open-ultrasound/open-imager/Hardware/1010260-900-0012_PCB/ch1477998-1 - Stackup Report.pdf

# STACKUP & IMPEDANCE REPORT

Page 1 of 1

### Planner: RICKG Confidential / Proprietary Information

### Customer Required Finished Thickness: 86.00 (+8.60 / -8.60) mils

### Measured: Over mask on plated copper

### Job Name: Customer:

ch1477998-1

### Part Name:

### Creare Stack-up

Revision: | Estimated Thickness after Lamination: 84.18 mils

Outer layers to finish at 1 oz.

### Preliminary stack up : Data not provided

### Stackup Notes:

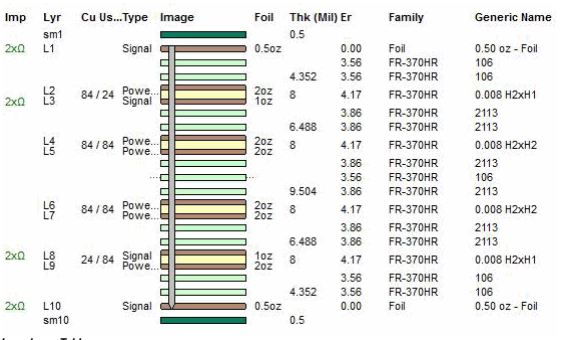
[picture p9: figure]

Index | Layer | Required Impedance [ohms] | Tol [ohms] +/- | Type | Ref 1 | Ref 2 | Orig LW [mil] | Orig Spacing [mil] | Orig CP Spacing [mil] | Finished LW [mil] | Finished Spacing [mil] | Fin. CP Spacing [mil] | Impedance Simulation [ohms] | Impedance before Mask [ohms] | IMG
a | 1 | 100 | 10% | Diff Coated | | 2 | 5.50 | 6.90 | | 5.50 | 6.90 | | 99.8
b | 10 | 100 | 10% | Diff Coated | | 9 | 5.50 | 6.90 | | 5.50 | 6.90 | | 99.8
c | 3 | 100 | 10% | Diff Stripline | 4 | 2 | 4.70 | 8.00 | | 4.70 | 8.00 | | 99.3
d | 8 | 100 | 10% | Diff Stripline | 7 | 9 | 4.70 | 8.00 | | 4.70 | 8.00 | | 99.3
e | 1 | 50 | 10% | SE Coated | | 2 | 7.70 | | | 7.70 | | | 49.9
f | 3 | 50 | 10% | SE Stripline | 4 | 2 | 6.00 | | | 6.00 | | | 49.6
g | 8 | 50 | 10% | SE Stripline | 7 | 9 | 6.00 | | | 6.00 | | | 49.6
h | 10 | 50 | 10% | SE Coated | | 9 | 7.70 | | | 7.70 | | | 49.9

Impedance Table

Report Version 1.60 | Report Print Date/Time: 1/28/2020 | 11:46:08AM | Page 1 of 1
