open-ultrasound/open-imager/OpenImageEval/OpenImageEval.sdk/FSBL/bootimage/ProgramFlashMemory.png

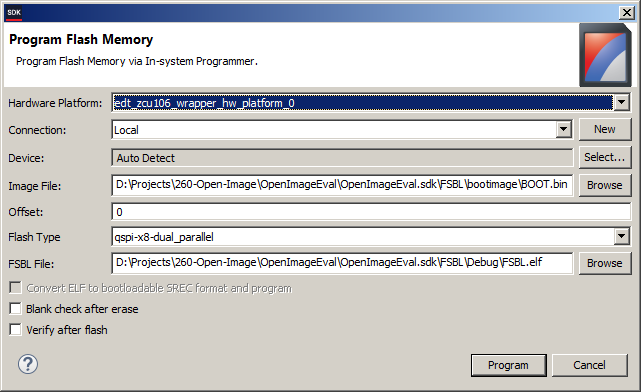
OpenImageEval/OpenImageEval.sdk/FSBL/bootimage/ProgramFlashMemory.png
