open-ultrasound/open-imager/Documents/OpenImageDesign.xlsx

Sheet: FMC Pinout, J5 Mate
J5 Pin | Eval Schematic Net Name | I/O Standard | U1 Pin | U1 Bank | Interposer Net Name | Destination I/C | Pin
C10 | FMC_HPC0_LA06_P | LVCMOS18 | H19 |  | PLSR3_SEL2 | HV7321 #3 | 16
C11 | FMC_HPC0_LA06_N | LVCMOS18 | G19 |  | PLSR3_CLK |  | 8
C14 | FMC_HPC0_LA10_P | LVCMOS18 | L15 |  | PLSR2_NEG3 | HV7321 #2 | 17
C15 | FMC_HPC0_LA10_N | LVCMOS18 | K15 |  | PLSR2_NEG2 |  | 13
C18 | FMC_HPC0_LA14_P | LVCMOS18 | C13 |  | AFE_TRIGp | Both AD9670 | J2
C19 | FMC_HPC0_LA14_N | LVCMOS18 | C12 |  | AFE_TRIGn | Both AD9670 | H2
C22 | FMC_HPC0_LA18_CC_P | LVCMOS18 | D11 |  | PLSR1_NEG3 | HV7321 #1 | 17
C23 | FMC_HPC0_LA18_CC_N | LVCMOS18 | D10 |  | PLSR1_NEG2 |  | 13
C26 | FMC_HPC0_LA27_P | LVCMOS18 | A8 |  | PLSR1_NEG1 |  | 3
C27 | FMC_HPC0_LA27_N | LVCMOS18 | A7 |  | PLSR1_SEL0 |  | 62
C34 | GND |  |  |  | GND
C35 | VCC12_SW |  |  |  | V1.2
C37 | VCC12_SW |  |  |  | V1.2
C39 | UTIL_3V3 |  |  |  | V3.3
D8 | FMC_HPC0_LA01_CC_P | LVCMOS18 | H18 |  | PLSR2_NEG1 | HV7321 #2 | etc.
D9 | FMC_HPC0_LA01_CC_N | LVCMOS18 | H17 |  | PLSR2_SEL0
D11 | FMC_HPC0_LA05_P | LVCMOS18 | K17 |  | PLSR2_NEG0
D12 | FMC_HPC0_LA05_N | LVCMOS18 | J17 |  | PLSR2_POS3
D14 | FMC_HPC0_LA09_P | LVCMOS18 | H16 |  | PLSR2_SEL1
D15 | FMC_HPC0_LA09_N | LVCMOS18 | G16 |  | PLSR2_POS2
D17 | FMC_HPC0_LA13_P | LVCMOS18 | G15 |  | PLSR2_POS1
D18 | FMC_HPC0_LA13_N | LVCMOS18 | F15 |  | PLSR2_POS0
D20 | FMC_HPC0_LA17_CC_P | LVCMOS18 | F11 |  | AFE1_FCOp | AD9670 #1 | L7
D21 | FMC_HPC0_LA17_CC_N | LVCMOS18 | E10 |  | AFE1_FCOn |  | M7
D23 | FMC_HPC0_LA23_P | LVCMOS18 | B11 |  | PLSR1_SEL3 | HV7321 #1
D24 | FMC_HPC0_LA23_N | LVCMOS18 | A11 |  | PLSR1_SEL2
D26 | FMC_HPC0_LA26_P | LVCMOS18 | B9 |  | PLSR1_CLK
D27 | FMC_HPC0_LA26_N | LVCMOS18 | B8 |  | PLSR3_SEL3 | HV7321 #3
D32 | UTIL_3V3 |  |  |  | V3.3
D35 | GND |  |  |  | GND
D36 | UTIL_3V3 |  |  |  | V3.3
D38 | UTIL_3V3 |  |  |  | V3.3
D40 | UTIL_3V3 |  |  |  | V3.3
E39 | VADJ_FMC_BUS |  |  |  | V1.8
F40 | VADJ_FMC_BUS |  |  |  | V1.8
G2 | FMC_HPC0_CLK1_M2C_P | LVDS | G10 |  | AFE1_DCOp | AD9670 #1 | L6
G3 | FMC_HPC0_CLK1_M2C_N | LVDS | F10 |  | AFE1_DCOn |  | M6
G6 | FMC_HPC0_LA00_CC_P | LVDS | F17 |  | AFE0_FCOp | AD9670 #0 | L7
G7 | FMC_HPC0_LA00_CC_N | LVDS | F16 |  | AFE0_FCOn |  | M7
G9 | FMC_HPC0_LA03_P | LVCMOS18 | K19 |  | AFE0_DATA2p |  | L9
G10 | FMC_HPC0_LA03_N | LVCMOS18 | K18 |  | AFE0_DATA2n |  | M9
G12 | FMC_HPC0_LA08_P | LVCMOS18 | E18 |  | AFE0_DATA1p |  | L10
G13 | FMC_HPC0_LA08_N | LVCMOS18 | E17 |  | AFE0_DATA1n |  | M10
G15 | FMC_HPC0_LA12_P | LVCMOS18 | G18 |  | AFE0_DATA0p |  | L11
G16 | FMC_HPC0_LA12_N | LVCMOS18 | F18 |  | AFE0_DATA0n |  | M11
G18 | FMC_HPC0_LA16_P | LVCMOS18 | D17 |  | PLSR2_SEL3 | HV7321 #2
G19 | FMC_HPC0_LA16_N | LVCMOS18 | C17 |  | PLSR2_SEL2
G21 | FMC_HPC0_LA20_P | LVCMOS18 | F12 |  | PLSR2_CLK
G22 | FMC_HPC0_LA20_N | LVCMOS18 | E12 |  | Testpoint pad.
G24 | FMC_HPC0_LA22_P | LVCMOS18 | H13 |  | AFE1_DATA7p | AD9670 #1 | L2
G25 | FMC_HPC0_LA22_N | LVCMOS18 | H12 |  | AFE1_DATA7n |  | M2
G27 | FMC_HPC0_LA25_P | LVCMOS18 | C7 |  | AFE1_DATA6p |  | L3
G28 | FMC_HPC0_LA25_N | LVCMOS18 | C6 |  | AFE1_DATA6n |  | M3
G30 | FMC_HPC0_LA29_P | LVCMOS18 | K10 |  | AFE1_DATA5p |  | L4
G31 | FMC_HPC0_LA29_N | LVCMOS18 | J10 |  | AFE1_DATA5n |  | M4
G33 | FMC_HPC0_LA31_P | LVCMOS18 | F7 |  | AFE1_DATA4p |  | L5
G34 | FMC_HPC0_LA31_N | LVCMOS18 | E7 |  | AFE1_DATA4n |  | M5
G36 | FMC_HPC0_LA33_P | LVCMOS18 | C9 |  | AFE1_DATA3p |  | L8
G37 | FMC_HPC0_LA33_N | LVCMOS18 | C8 |  | AFE1_DATA3n |  | M8
G39 | VADJ_FMC_BUS |  |  |  | V1.8
H4 | FMC_HPC0_CLK0_M2C_P | LVDS | E15 |  | AFE0_DCOp | AD9670 #0 | L6
H5 | FMC_HPC0_CLK0_M2C_N | LVDS | E14 |  | AFE0_DCOn |  | M6
H7 | FMC_HPC0_LA02_P | LVCMOS18 | L20 |  | AFE0_DATA7p |  | L2
H8 | FMC_HPC0_LA02_N | LVCMOS18 | K20 |  | AFE0_DATA7n |  | M2
H10 | FMC_HPC0_LA04_P | LVCMOS18 | L17 |  | AFE0_DATA6p |  | L3
H11 | FMC_HPC0_LA04_N | LVCMOS18 | L16 |  | AFE0_DATA6n |  | M3
H13 | FMC_HPC0_LA07_P | LVCMOS18 | J16 |  | AFE0_DATA5p |  | L4
H14 | FMC_HPC0_LA07_N | LVCMOS18 | J15 |  | AFE0_DATA5n |  | M4
H16 | FMC_HPC0_LA11_P | LVCMOS18 | A13 |  | AFE0_DATA4p |  | L5
H17 | FMC_HPC0_LA11_N | LVCMOS18 | A12 |  | AFE0_DATA4n |  | M5
H19 | FMC_HPC0_LA15_P | LVCMOS18 | D16 |  | AFE0_DATA3p |  | L8
H20 | FMC_HPC0_LA15_N | LVCMOS18 | C16 |  | AFE0_DATA3n |  | M8
H22 | FMC_HPC0_LA19_P | LVCMOS18 | D12 |  | AFE1_DATA2p | AD9670 #1 | L9
H23 | FMC_HPC0_LA19_N | LVCMOS18 | C11 |  | AFE1_DATA2n |  | M9
H25 | FMC_HPC0_LA21_P | LVCMOS18 | B10 |  | AFE1_DATA1p |  | L10
H26 | FMC_HPC0_LA21_N | LVCMOS18 | A10 |  | AFE1_DATA1n |  | M10
H28 | FMC_HPC0_LA24_P | LVCMOS18 | B6 |  | AFE1_DATA0p |  | L11
H29 | FMC_HPC0_LA24_N | LVCMOS18 | A6 |  | AFE1_DATA0n |  | M11
H31 | FMC_HPC0_LA28_P | LVCMOS18 | M13 |  | PLSR1_NEG0 | HV7321 #1
H32 | FMC_HPC0_LA28_N | LVCMOS18 | L13 |  | PLSR1_POS3
H34 | FMC_HPC0_LA30_P | LVCMOS18 | E9 |  | PLSR1_SEL1
H35 | FMC_HPC0_LA30_N | LVCMOS18 | D9 |  | PLSR1_POS2
H37 | FMC_HPC0_LA32_P | LVCMOS18 | F8 |  | PLSR1_POS1
H38 | FMC_HPC0_LA32_N | LVCMOS18 | E8 |  | PLSR1_POS0
H40 | VADJ_FMC_BUS |  |  |  | V1.8

Sheet: FMC Pinout, J4 Mate
J4 Pin | Eval Schematic Net Name | I/O Standard | U1 Pin | U1 Bank | Interposer Net Name | Destination I/C | Pin
C10 | FMC_HPC1_LA06_P | LVDS | H21 |  | DAC_D4 | Both AD5424 | 7
C11 | FMC_HPC1_LA06_N | LVDS | H22 |  | DAC_D3 |  | 8
C14 | FMC_HPC1_LA10_P | LVDS | F22 |  | DAC_D5 |  | 6
C15 | FMC_HPC1_LA10_N | LVDS | E22 |  | DAC_D6 |  | 5
C18 | FMC_HPC1_LA14_P | LVDS | D20 |  | DAC1_CSn | AD5424 #1 | 12
C19 | FMC_HPC1_LA14_N | LVDS | D21 |  | DAC_D0 | Both AD5424 | 11
C34 | GND |  |  |  | GND
C35 | VCC12_SW |  |  |  | V1.2
C37 | VCC12_SW |  |  |  | V1.2
C39 | UTIL_3V3 |  |  |  | V3.3
D8 | FMC_HPC1_LA01_CC_P | LVDS | E24 |  | PLSR3_NEG3 | HV7321 #3
D9 | FMC_HPC1_LA01_CC_N | LVDS | D24 |  | PLSR0_CLK | HV7321 #0
D11 | FMC_HPC1_LA05_P | LVDS | G25 |  | PLSR0_SEL0
D12 | FMC_HPC1_LA05_N | LVDS | G26 |  | PLSR0_SEL1
D14 | FMC_HPC1_LA09_P | LVDS | G20 |  | DAC_D7 | Both AD5424 | 4
D15 | FMC_HPC1_LA09_N | LVDS | F20 |  | DAC0_CSn | AD5424 #0 | 11
D17 | FMC_HPC1_LA13_P | LVDS | C21 |  | PLSR3_NEG2
D18 | FMC_HPC1_LA13_N | LVDS | C22 |  | PLSR3_POS0
D32 | UTIL_3V3 |  |  |  | V3.3
D35 | GND |  |  |  | GND
D36 | UTIL_3V3 |  |  |  | V3.3
D38 | UTIL_3V3 |  |  |  | V3.3
D40 | UTIL_3V3 |  |  |  | V3.3
E39 | VADJ_FMC_BUS |  |  |  | V1.8
F40 | VADJ_FMC_BUS |  |  |  | V1.8
G6 | FMC_HPC1_LA00_CC_P | LVDS | B18 |  | PLSR0_NEG0 | HV7321 #0
G7 | FMC_HPC1_LA00_CC_N | LVDS | B19 |  | PLSR0_NEG1
G9 | FMC_HPC1_LA03_P | LVDS | J21 |  | PLSR3_NEG1 | HV7321 #3
G10 | FMC_HPC1_LA03_N | LVDS | J22 |  | bring to testpoint pad
G12 | FMC_HPC1_LA08_P | LVDS | J25 |  | AFE_CLKp | Both AD9670 | J1
G13 | FMC_HPC1_LA08_N | LVDS | H26 |  | AFE_CLKn |  | H1
G15 | FMC_HPC1_LA12_P | LVDS | E19 |  | PLSR3_SEL0 | HV7321 #3
G16 | FMC_HPC1_LA12_N | LVDS | D19 |  | PLSR3_NEG0
G18 | FMC_HPC1_LA16_P | LVDS | C18 |  | PLSR0_POS0 | HV7321 #0
G19 | FMC_HPC1_LA16_N | LVDS | C19 |  | PLSR0_POS1
G39 | VADJ_FMC_BUS |  |  |  | V1.8
H4 | FMC_HPC1_CLK0_M2C_P | LVDS | F23 |  | DAC_D1 | Both AD5424 | 10
H5 | FMC_HPC1_CLK0_M2C_N | LVDS | E23 |  | DAC_D2 |  | 9
H7 | FMC_HPC1_LA02_P | LVDS | K22 |  | PLSR3_POS3 | HV7321 #3
H8 | FMC_HPC1_LA02_N | LVDS | K23 |  | PLSR3_SEL1
H10 | FMC_HPC1_LA04_P | LVDS | J24 |  | PLSR3_POS2
H11 | FMC_HPC1_LA04_N | LVDS | H24 |  | PLSR3_POS1
H13 | FMC_HPC1_LA07_P | LVDS | D22 |  | PLSR0_SEL0 | HV7321 #0
H14 | FMC_HPC1_LA07_N | LVDS | C23 |  | PLSR0_SEL3
H16 | FMC_HPC1_LA11_P | LVDS | A20 |  | PLSR0_NEG2
H17 | FMC_HPC1_LA11_N | LVDS | A21 |  | PLSR0_NEG3
H19 | FMC_HPC1_LA15_P | LVDS | A18 |  | PLSR0_POS2
H20 | FMC_HPC1_LA15_N | LVDS | A19 |  | PLSR0_POS3
H40 | VADJ_FMC_BUS |  |  |  | V1.8

Sheet: Ribbon Pinout, J3 Mate
J3 Pin | Eval Schematic Net Name | I/O Standard | U1 Pin | U1 Bank | Interposer Net Name | Destination I/C | Pin
6 | L6N_AD6N_64_N | LVCMOS18 | K13 | 68 | PLSR_REN | All HV7321 | 11
8 | L6P_AD6P_64_P | LVCMOS18 | L14 | 68 | PLSR_OEN |  | 6
10 | L5N_AD14N_64_N | LVCMOS18 | J14 | 68 | PLSR0_OTPn | HV7321 #0 | 20
12 | L5P_AD14P_64_P | LVCMOS18 | K14 | 68 | PLSR1_OTPn | #1 | 20
14 | L4N_AD7N_64_N | LVCMOS18 | J11 | 68 | PLSR2_OTPn | #2 | 20
16 | L4P_AD7P_64_P | LVCMOS18 | K12 | 68 | PLSR3_OTPn | #3 | 20
18 | L3N_AD15N_64_N | LVCMOS18 | L11 | 68 | AFE_SDIO | Both AD9670 | J12
20 | L3P_AD15P_64_P | LVCMOS18 | L12 | 68 | AFE_SCK |  | K12
22 | L14N_HDGC_65_N | LVCMOS18 | G24 | 28 | AFE0_CSn | AD9670 #0 | H12
24 | L14P_HDGC_65_P | LVCMOS18 | G23 | 28 | AFE1_CSn | AD9670 #1 | H12
