open-ultrasound/open-imager/Hardware/1010260-900-0012_PCB/ASB.pdf

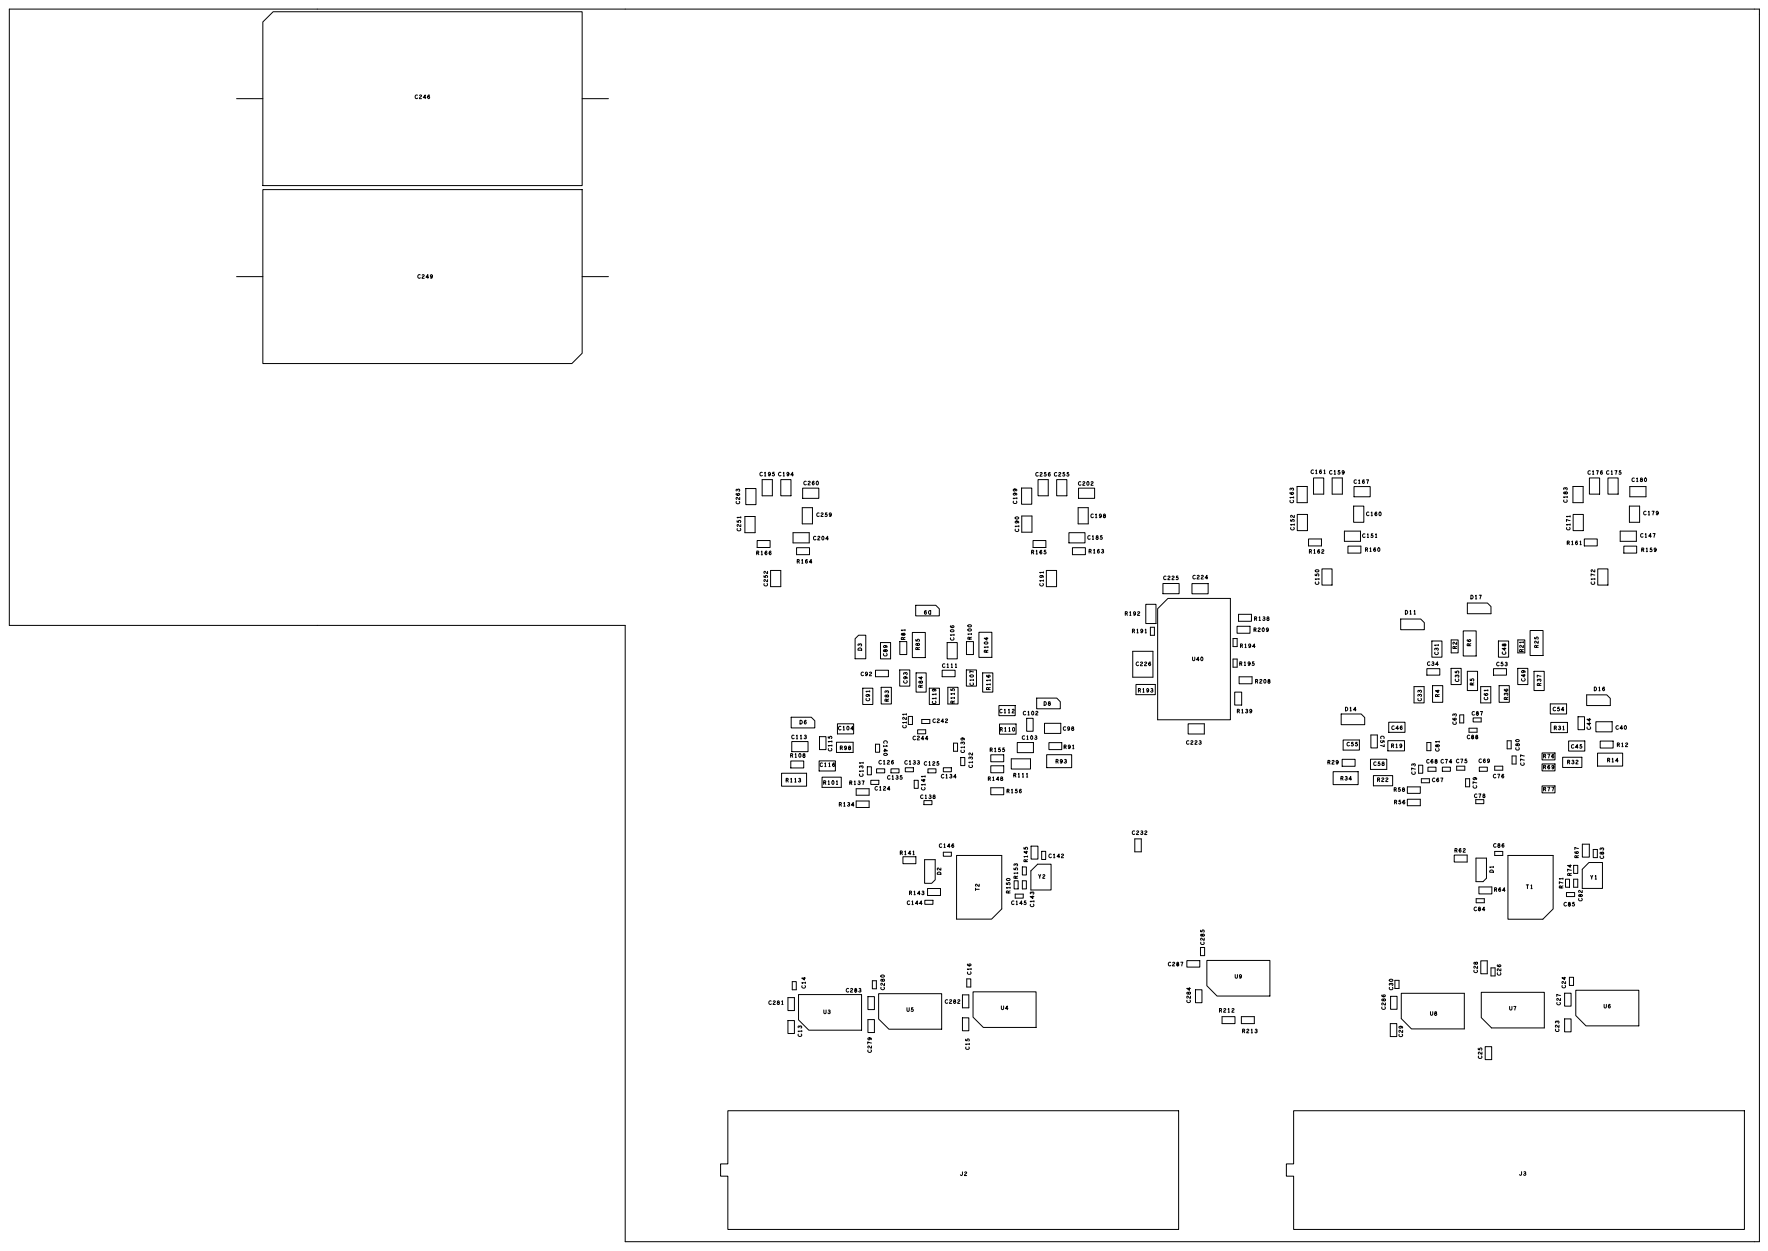
[picture p11: page 1]
