open-ultrasound/open-imager/Hardware/1010260-900-0012_PCB/AST.pdf

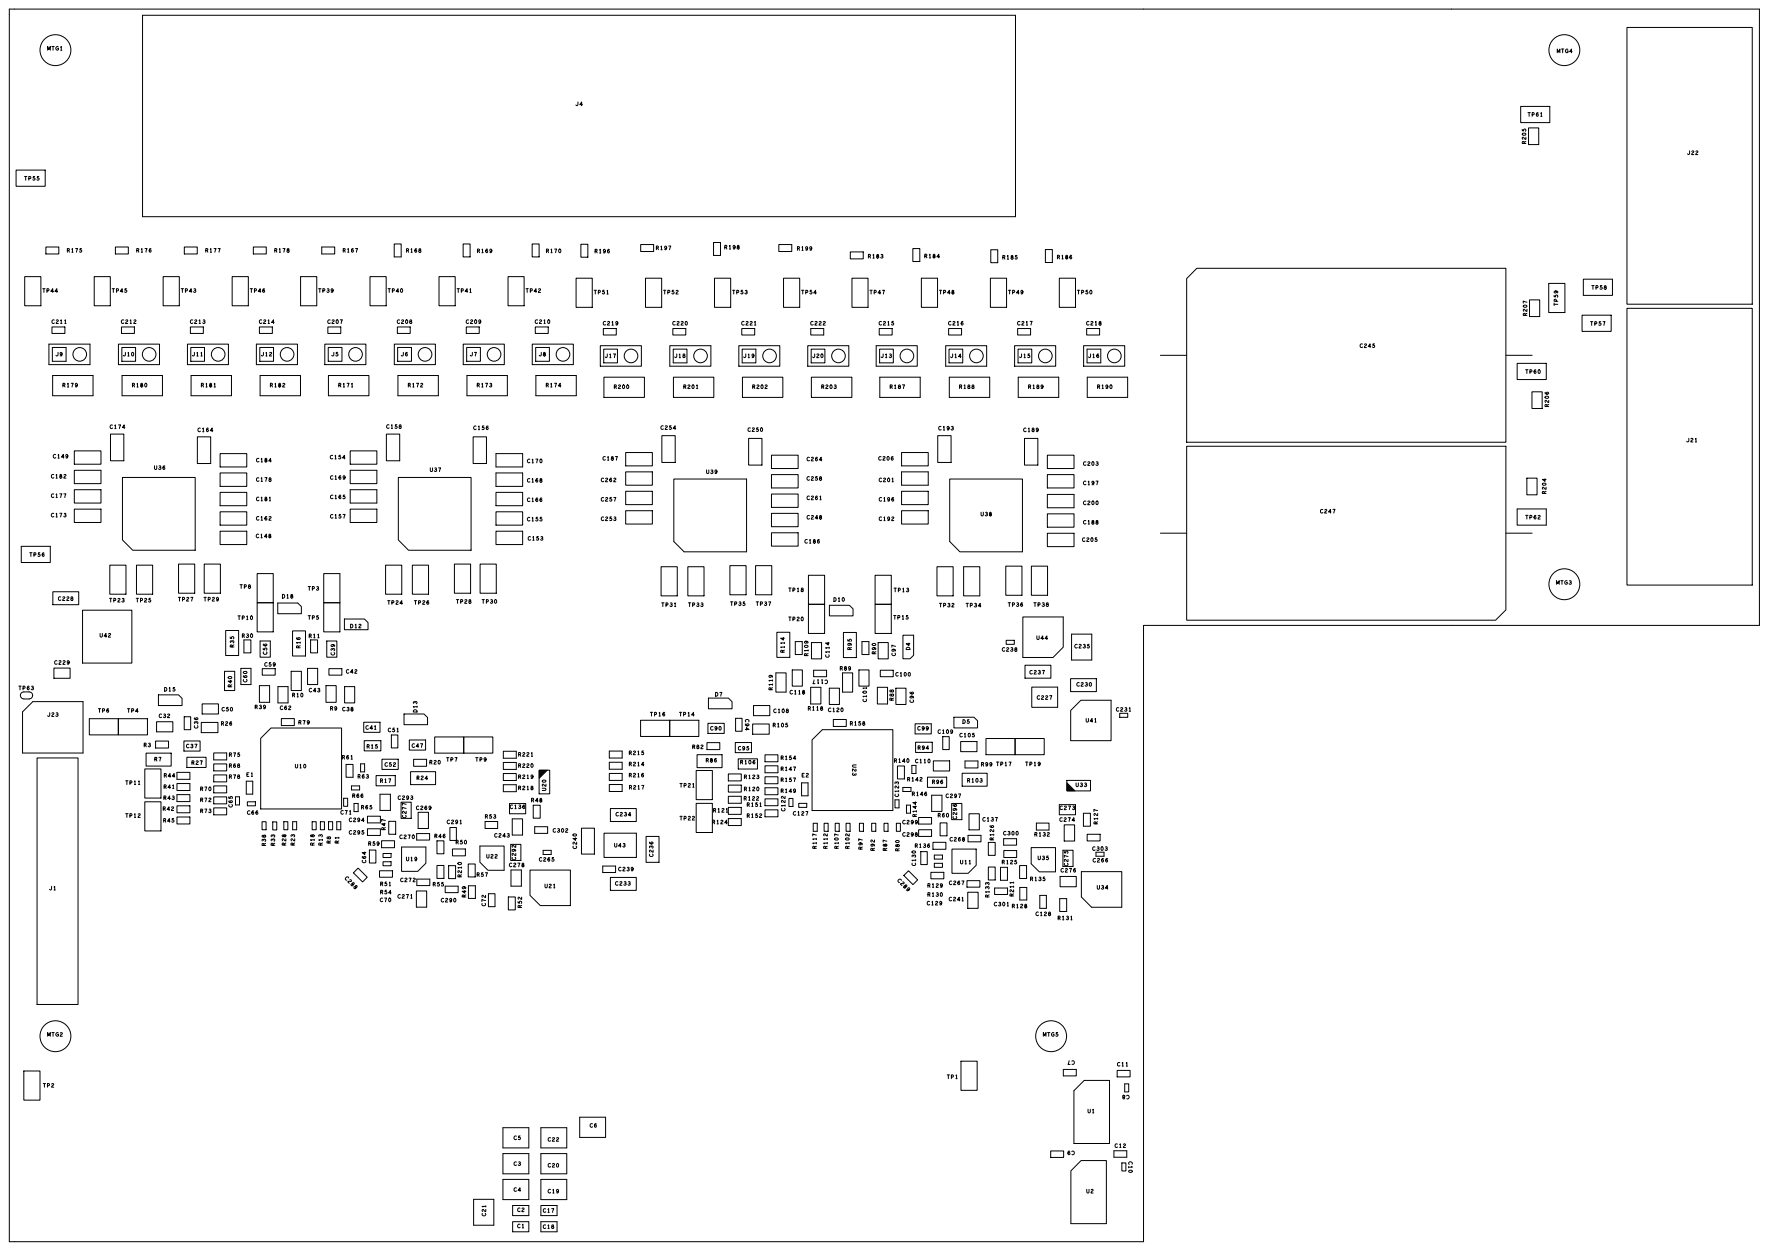
[picture p12: page 1]
