open-ultrasound/open-imager/Hardware/1010260-900-0012_PCB/FAB.pdf

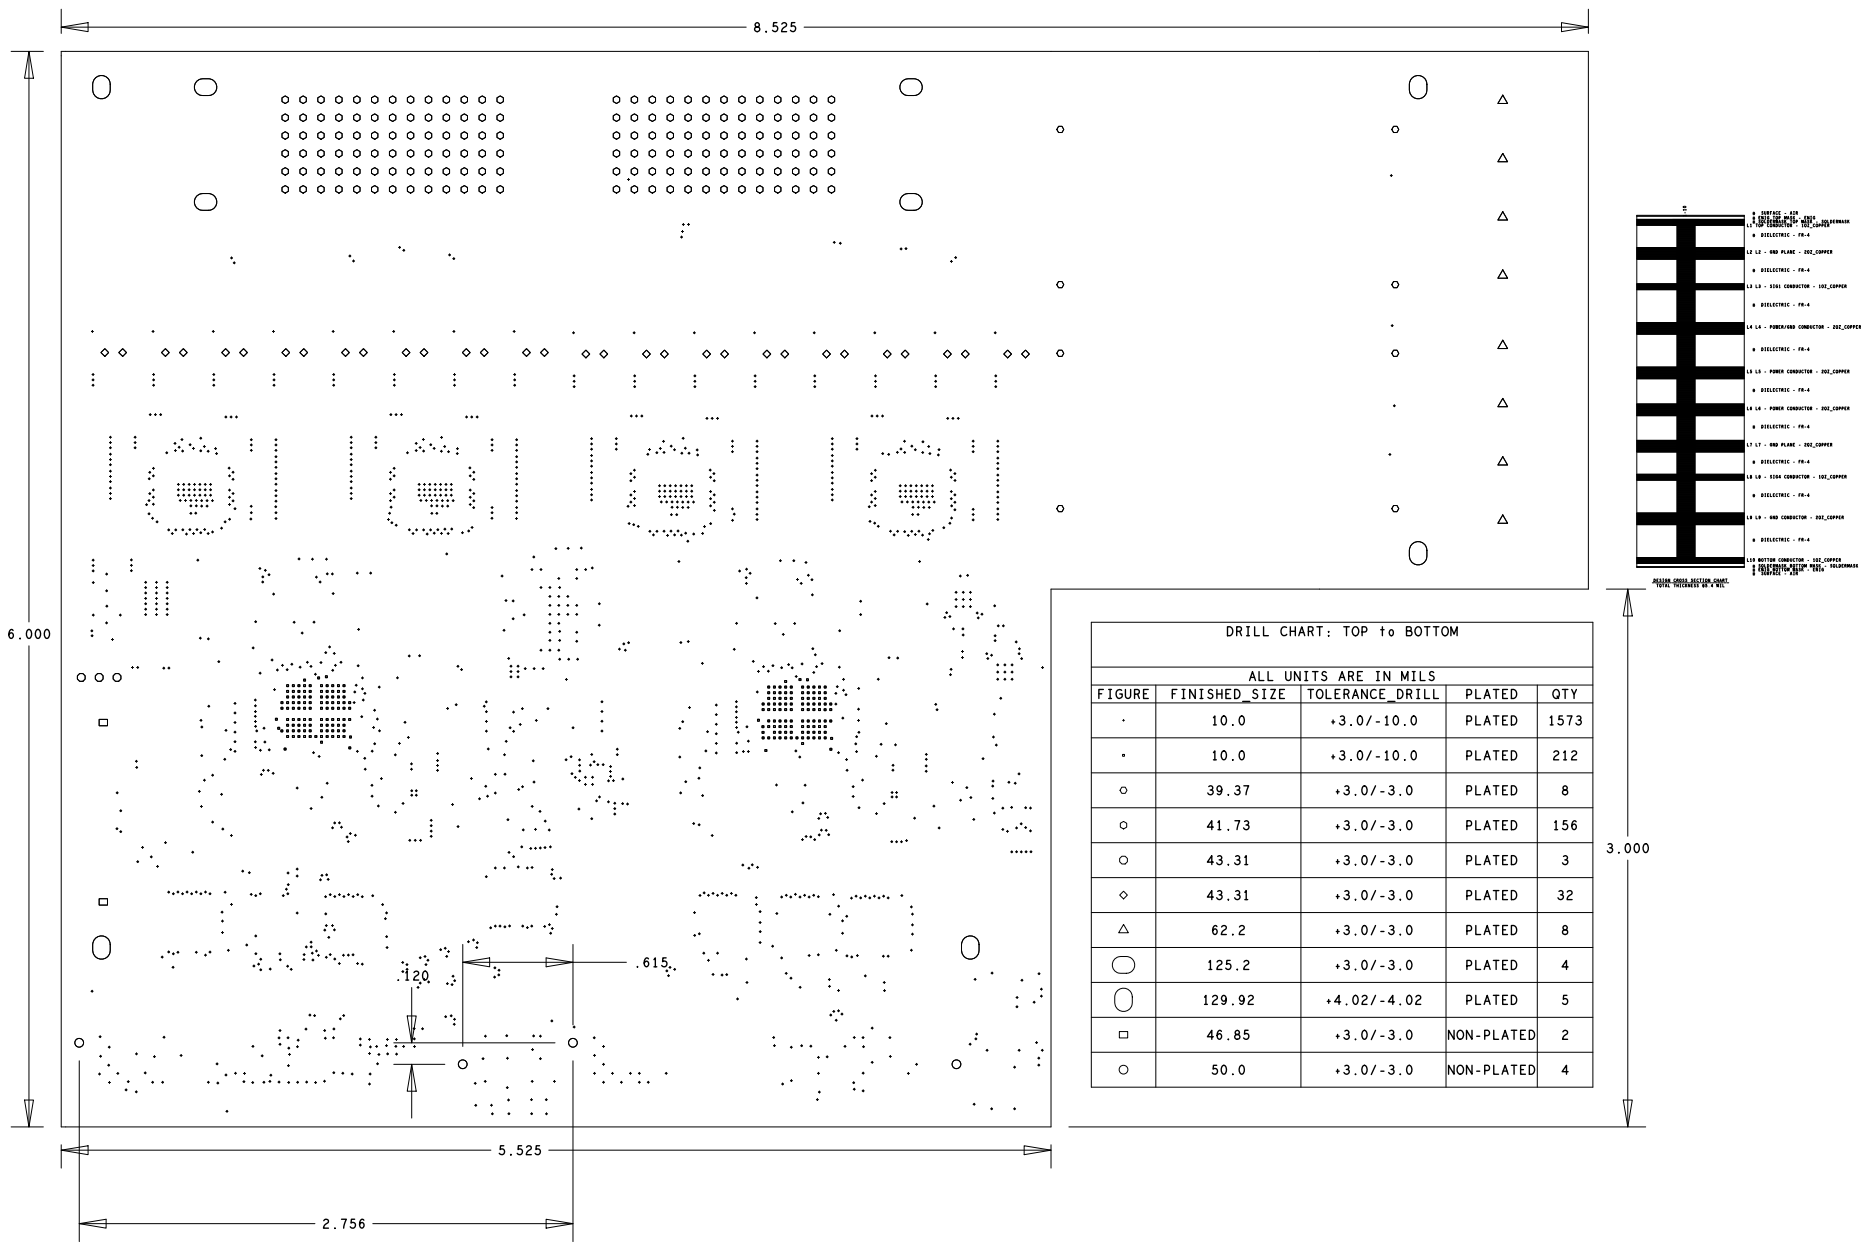
[picture p13: page 1]
