open-ultrasound/open-imager/Hardware/1010260-900-0013_Assembly/1010260-900-0013_ASB_Rev-A.pdf

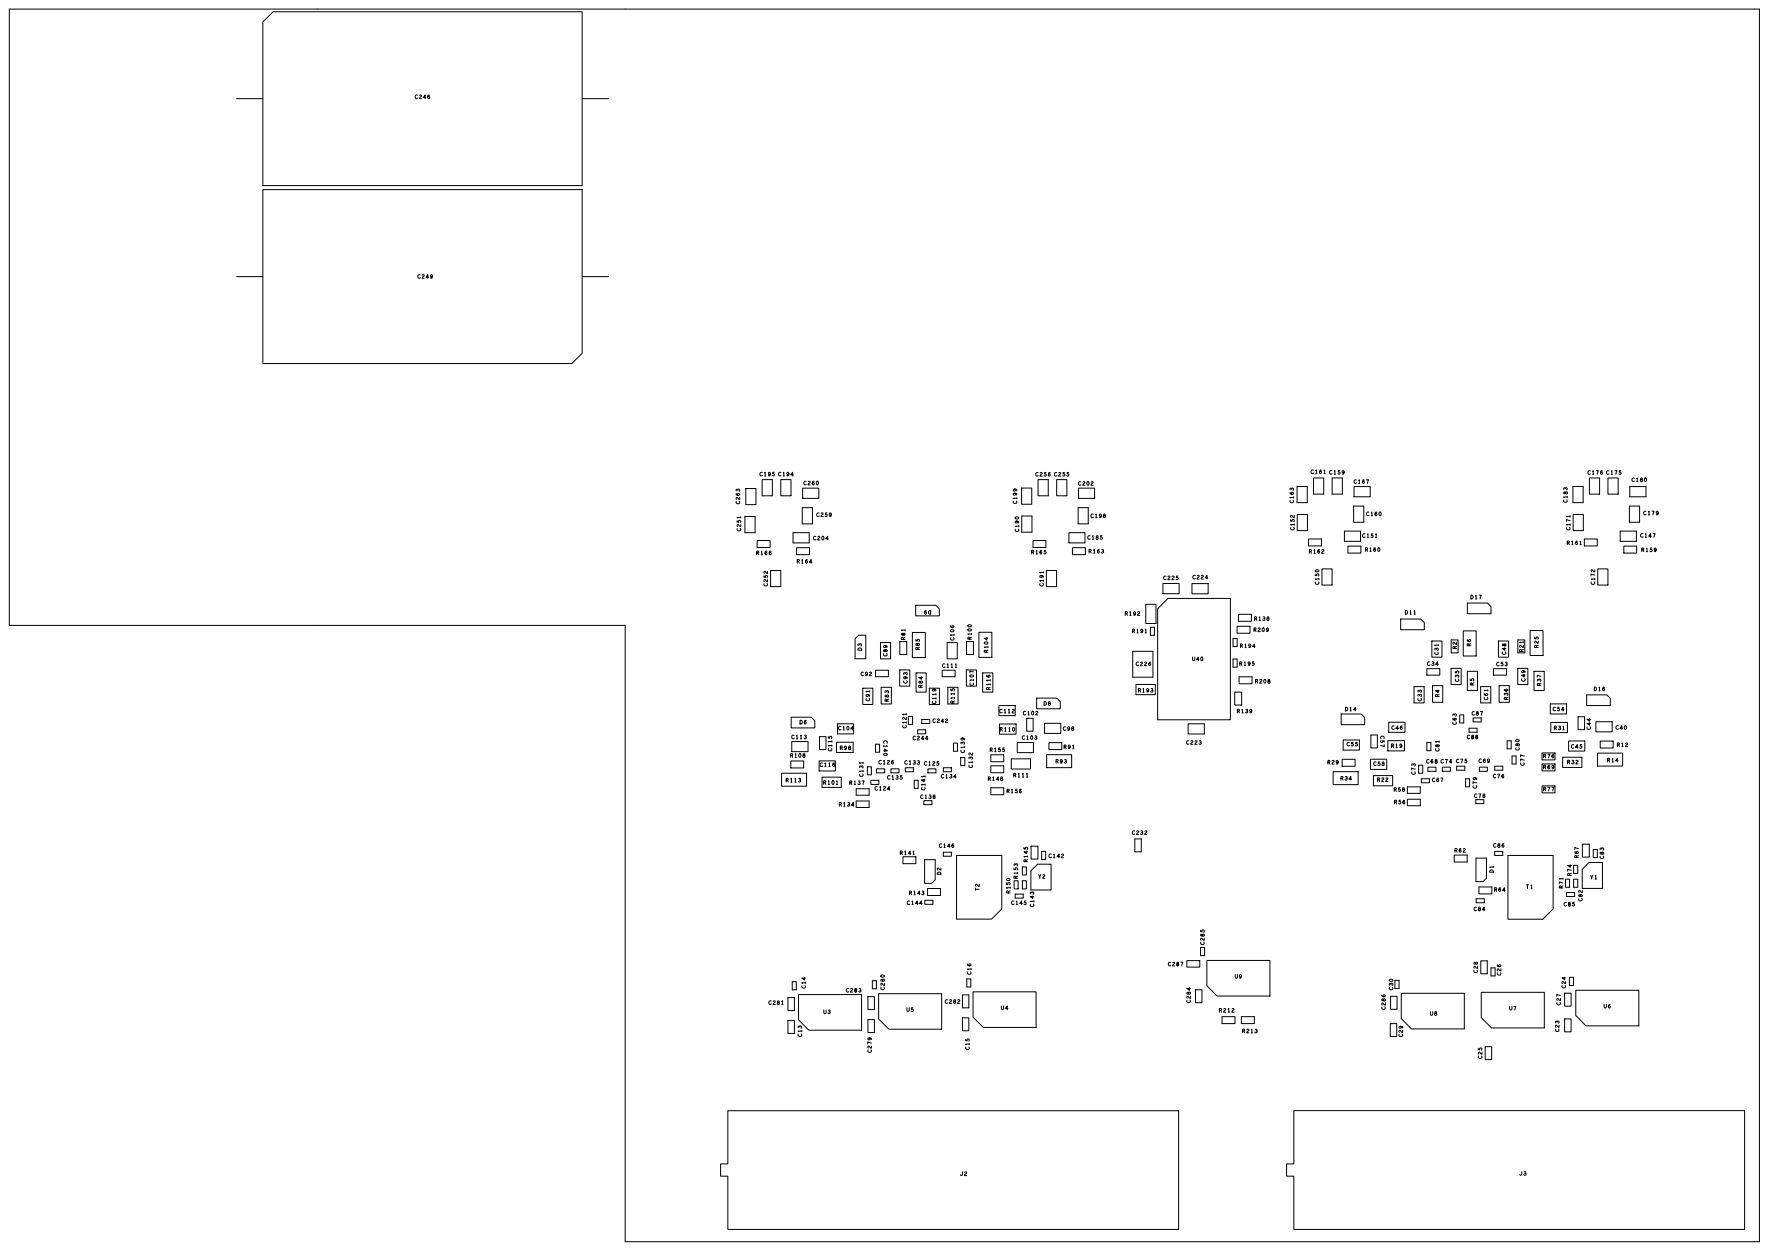
[picture p14: page 1]
