open-ultrasound/open-imager/Documents/Schematics/OIE_Firmware_Block_Diagram.pdf

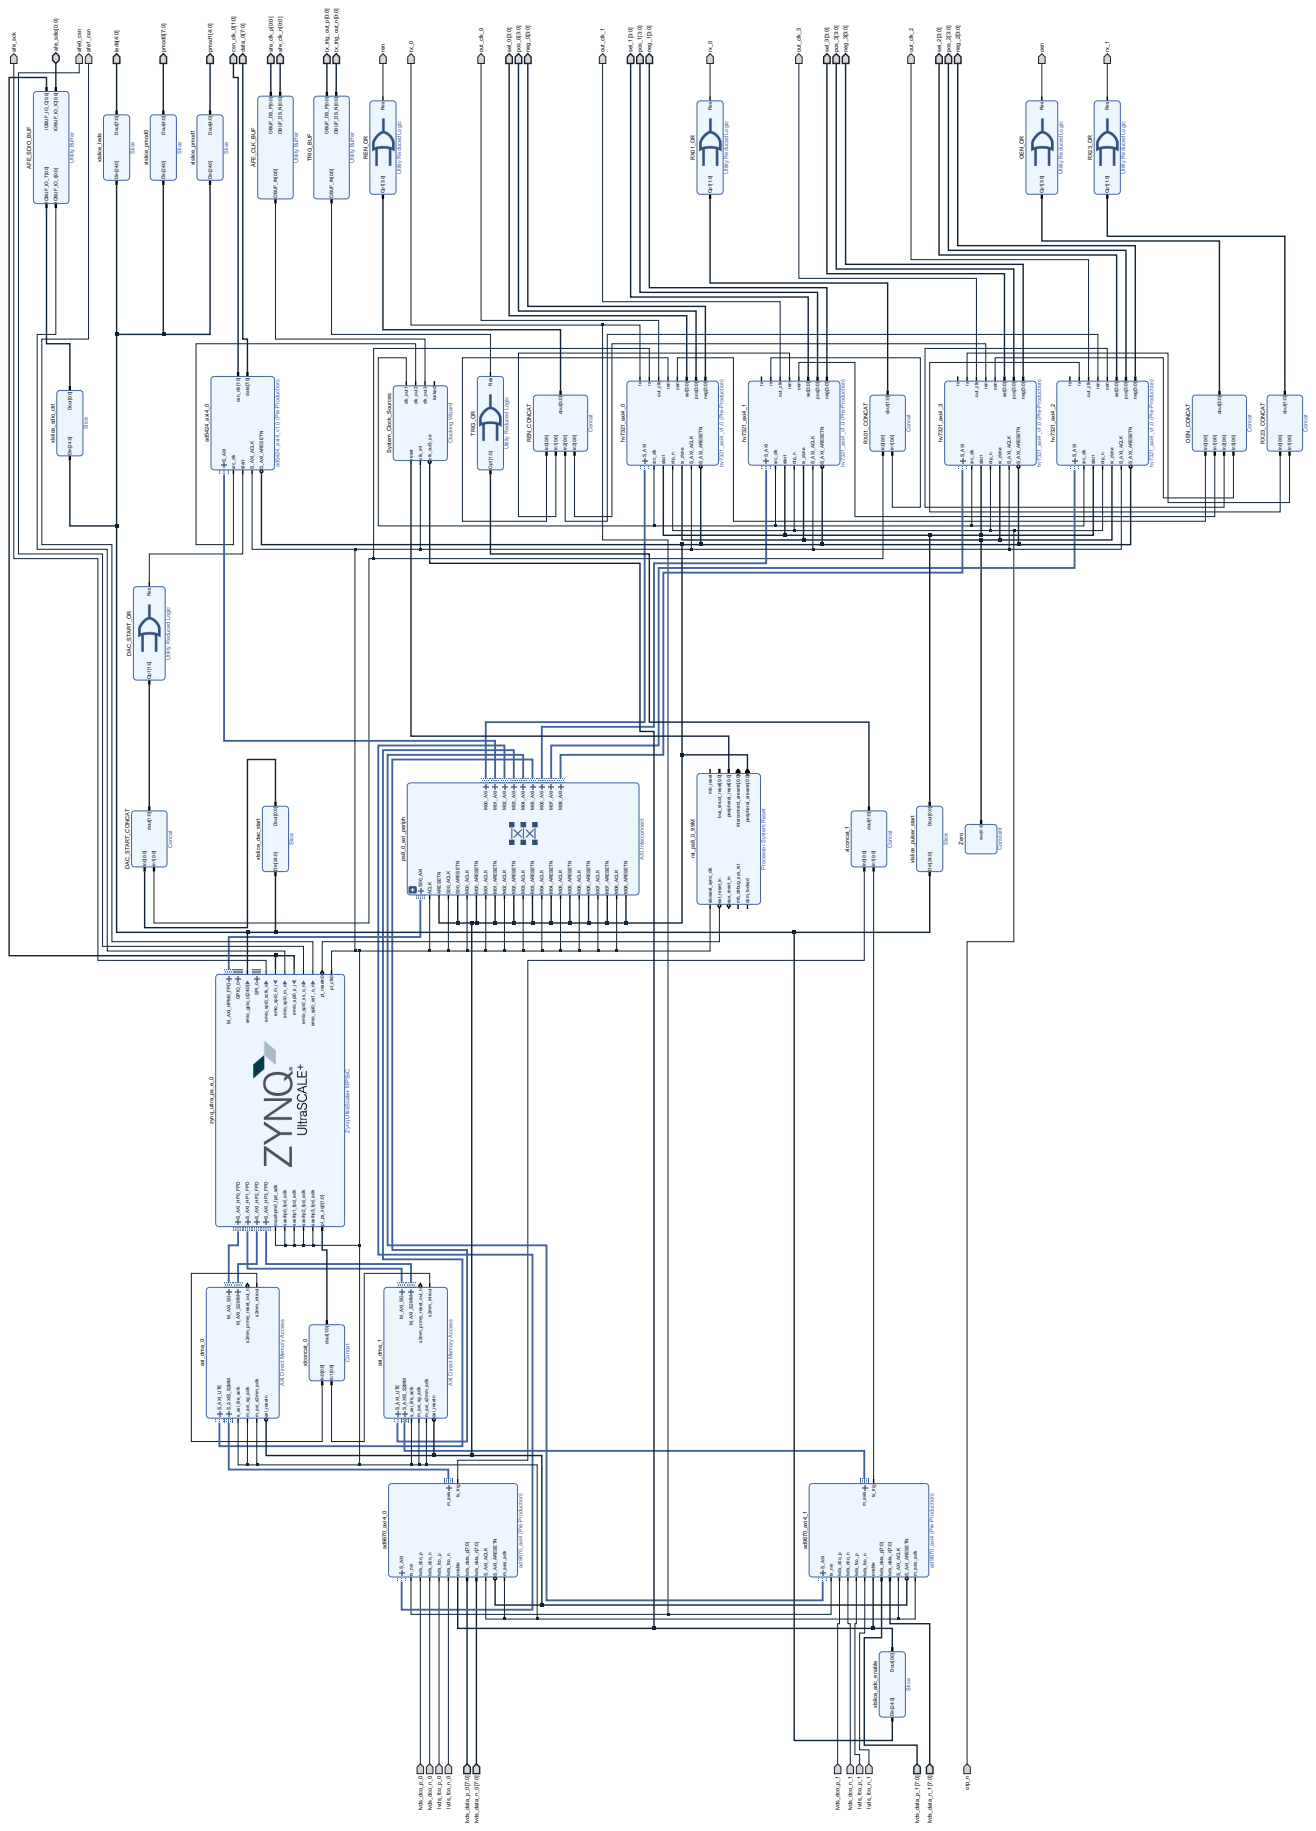
[picture p15: page 1]
AFE_CLK_BUF; Utility Buffer; OBUF_IN[0:0] OBUF_DS_P[0:0] OBUF_DS_N[0:0]; AFE_SDIO_BUF; IOBUF_IO_T[0:0]; IOBUF_IO_I[0:0]; IOBUF_IO_O[0:0]; IOBUF_IO_IO[0:0]; DAC_START_CONCAT; Concat; In1[0:0] dout[1:0]; DAC_START_OR; Op1[1:0] Res; OEN_CONCAT; dout[3:0]; OEN_OR; Op1[3:0] Res; REN_CONCAT; REN_OR; RX01_CONCAT; RX23_CONCAT; System_Clock_Sources; Clocking Wizard; reset clk_in1; clk_out1; clk_out2; clk_out3; locked; clk_out3_ce; TRIG_BUF; TRIG_OR; Zero; Constant; dout[0:0]; ad5424_axi4_0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

Utility Reduced Logic

sel[3:0] pos[3:0] neg[3:0]

Processor System Reset

Zynq UltraScale+ MPSoC

AXI Direct Memory Access
