open-ultrasound/open-imager/(list of files, drawings)

Other design files:
Hardware/1010260-900-0011_Schematic/1010260-900-0011_SCH_REV-A.DSN
