open-ultrasound/open-imager/OpenImageEval/OpenImageEval.srcs/sources_1/imports/AD9670_LVDS/dcm_freq_controller.v

`timescale 1ns / 1ps
//////////////////////////////////////////////////////////////////////////////////
// Company: 
// Engineer: 
// 
// Create Date:    07/07/2010
// Design Name: 
// Module Name:    dcm_freq_counter 
// Project Name: 
// Target Devices: 
// Tool versions: 
// Description: 
//
// Dependencies: 
//
// Revision: 
// Revision 0.01 - File Created
// Additional Comments: 
//
//////////////////////////////////////////////////////////////////////////////////
module dcm_freq_controller #
(
	parameter integer REF_FREQ    = 100000000,	// Reference frequency (100MHz default)
	parameter integer LF_MODE_MIN =  10000000,	// Minimum frequency for "low frequency" mode
	parameter integer LF_MODE_MAX = 150050000,	// Maximum frequency for "low frequency" mode
	parameter integer HF_MODE_MIN = 149950000,	// Minimum frequency for "high frequency" mode
	parameter integer HF_MODE_MAX = 650000000		// Maximum frequency for "high frequency" mode
)
(
	input  i_clk,						// Input clock to count
	input  i_ref_clk,					// Reference clock
	input  i_reset,						// Counter reset
	output o_freq_mode,				// Frequency mode (0 = low, 1 = high)
	output o_freq_or,					// Frequency out of range (0 = in range, 1 = out of range)
	output o_freq_set,				// Frequency set indicator
   output o_count_done           // Count done indicator
);

wire [31:0] freq_word;
wire freq_set;
wire count_done;

reg freq_mode_reg, freq_or_reg;
reg [31:0] freq_word_reg;
reg freq_set_reg;

// Assign outputs
assign o_freq_mode = freq_mode_reg;
assign o_freq_or = freq_or_reg;
assign o_freq_set = freq_set_reg;
assign o_count_done = count_done;

// Instantiate frequency counter.
dcm_counter 
 dcm_c (
	.i_clk(i_clk),
	.i_ref_clk(i_ref_clk),
	.i_reset(i_reset),
	.o_freq_word(freq_word),
	.o_freq_set(freq_set),
   .o_count_done(count_done)
);

// Assign frequency mode if word is outside transition band.
always @(posedge i_ref_clk) begin
	if (freq_word > LF_MODE_MAX/1000)
		freq_mode_reg <= 1'b1;
	else if (freq_word < HF_MODE_MIN/1000)
		freq_mode_reg <= 1'b0;
end

// Assign frequency out of range.
always @(posedge i_ref_clk) begin
	if ((freq_word < LF_MODE_MIN/1000) || (freq_word > HF_MODE_MAX/1000))
		freq_or_reg <= 1'b1;
	else
		freq_or_reg <= 1'b0;
end

always @(posedge i_ref_clk)
	freq_word_reg <= freq_word;

always @(posedge i_ref_clk)
	freq_set_reg <= freq_set;

endmodule
