open-ultrasound/open-imager/(commit log)

2021-02-25 Adding documentation, firmware, and software files.
    [OpenImageDesign.xlsx]
2021-02-25 Adding ORCAD design files.
    [1010260-900-0010_BOM_Rev-A.xlsx, 1010260-900-0011_SCH_REV-A.DSN]
